ronau/hoerbert-clone/Assembly.md

Assembly
========

Here are some photos and notes from the assembly.

Board and wiring
----------------

1. Soldering the micro switches to the matrix board as well as the ground wires.
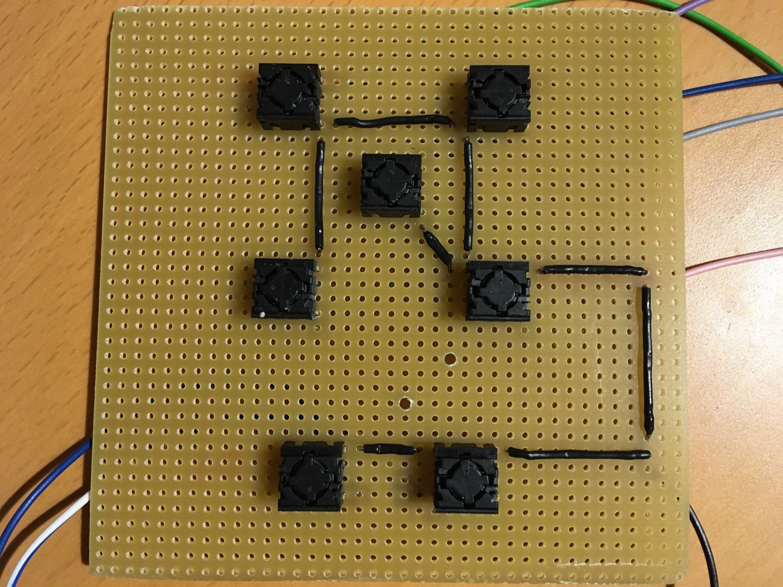
[picture p2: images/1_board_01.jpg]
1_board_01
  
2. Connecting the switches to the corresponding pins on the Lilypad (here: ground as well as fast-forward/backwards switches).
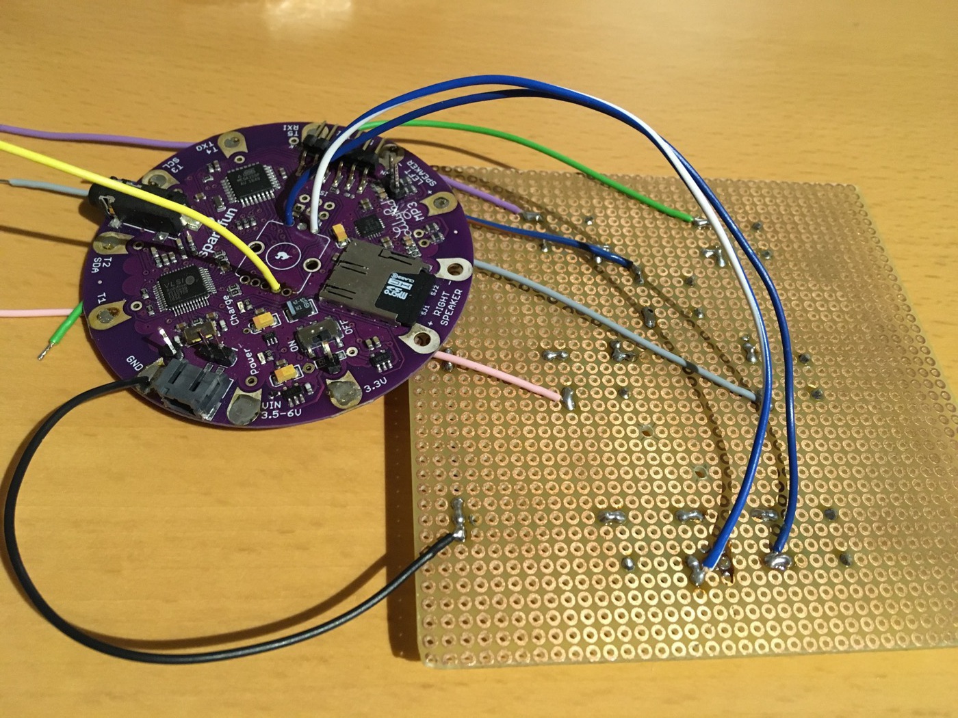
[picture p3: images/1_board_02.jpg]
1_board_02
  
3. Connecting the 5 playlist switches to the corresponding trigger pins on the Lilypad.
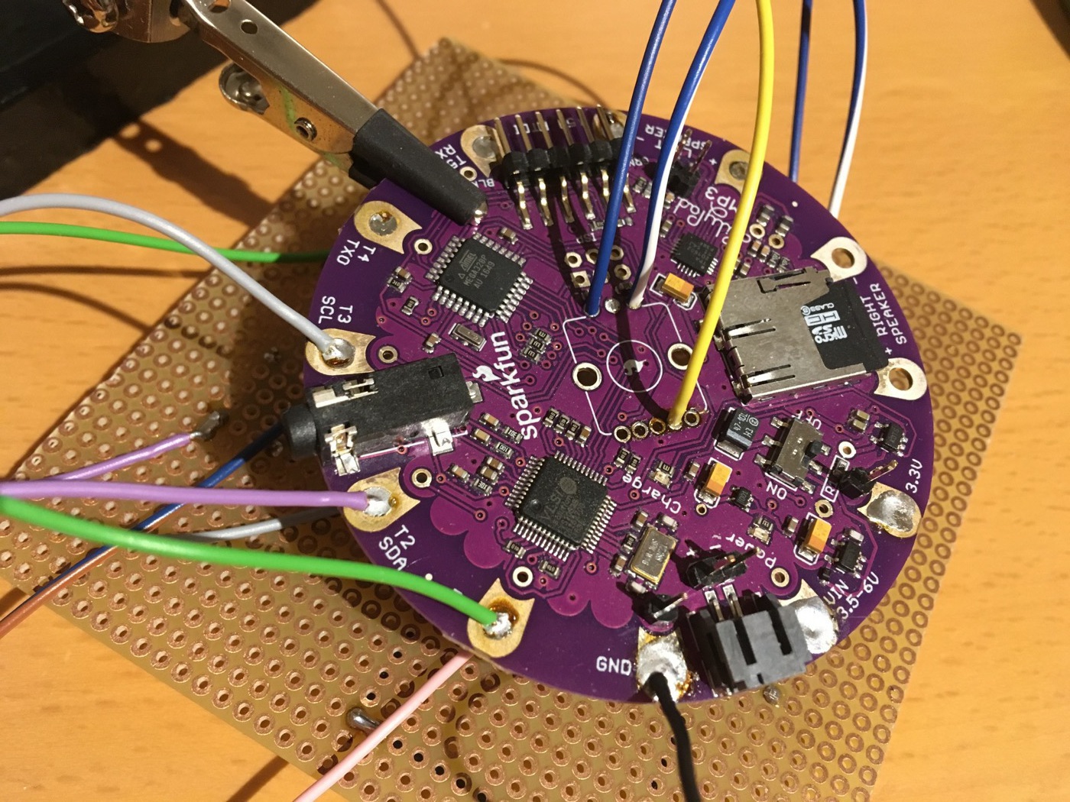
[picture p4: images/1_board_03.jpg]
1_board_02
  
4. Making sure the bottom of the Lilypad is protected when placing it above the matrix board.
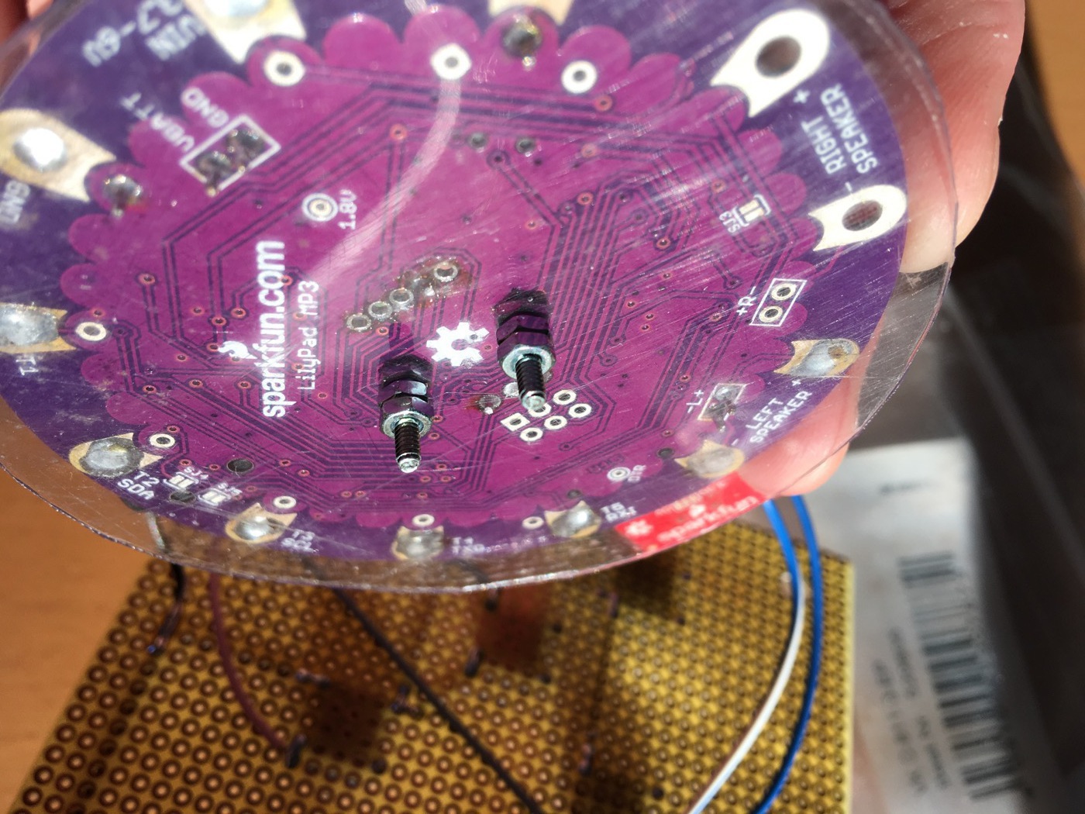
[picture p5: images/1_board_04.jpg]
1_board_04
   
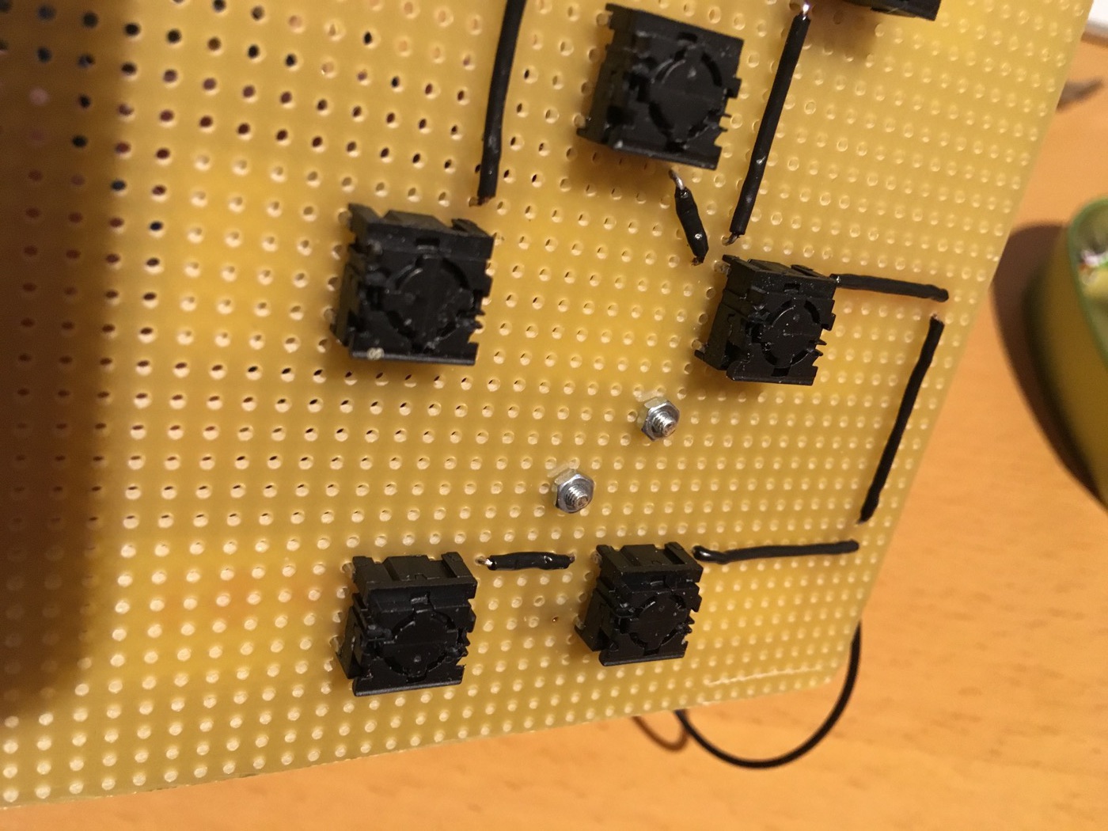
[picture p6: images/1_board_05.jpg]
1_board_05
   
5. Connecting potentiometer, battery and speaker and running some tests.
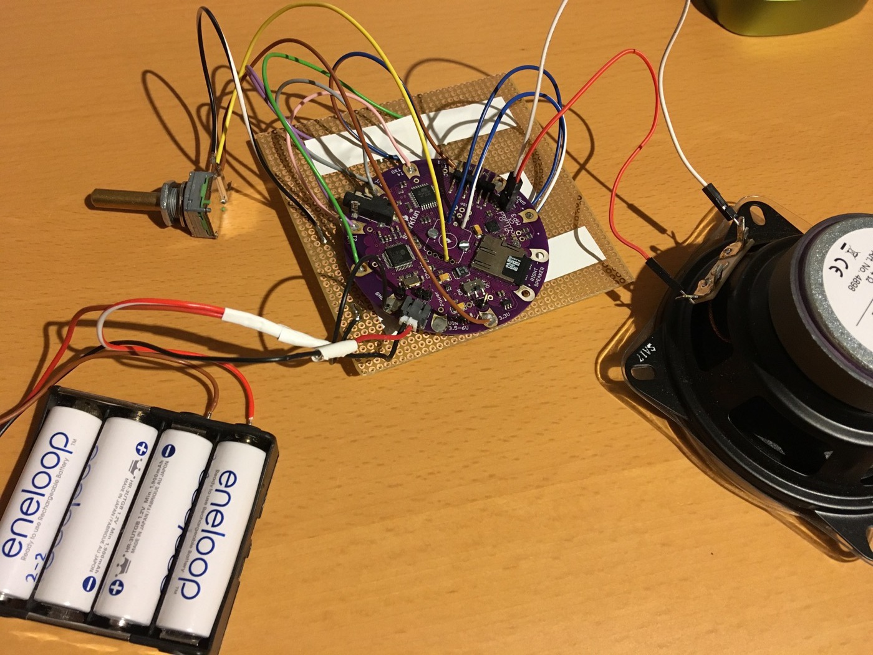
[picture p7: images/1_board_06.jpg]
1_board_06
   

Casing
------

1. Bezel for the speaker grid.
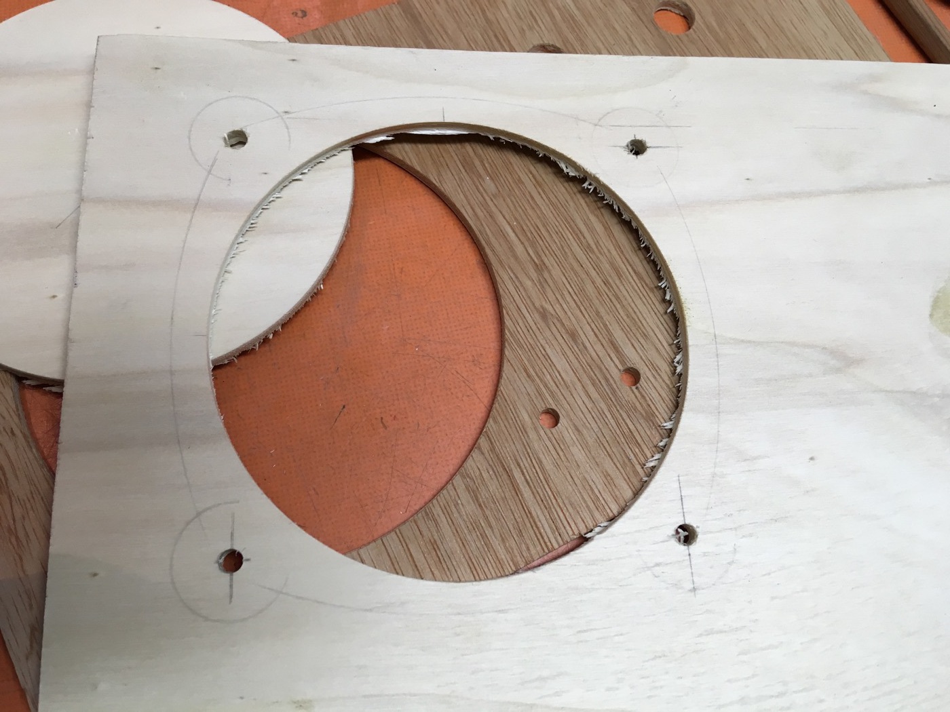
[picture p8: images/2_casing_01.jpg]
2_casing_01
   
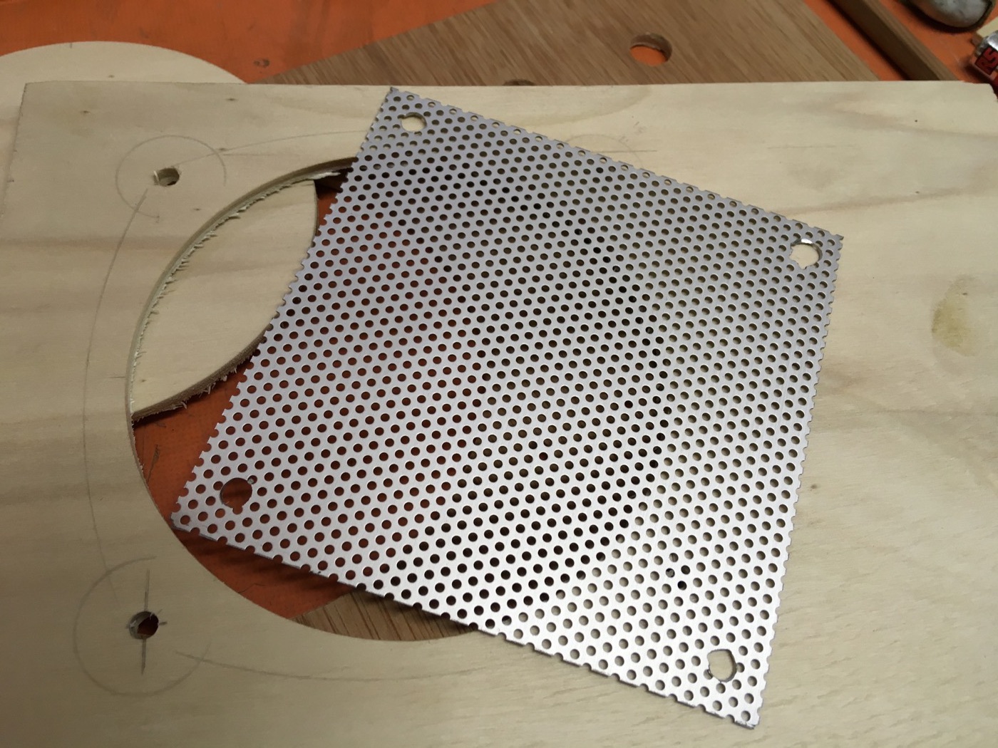
[picture p9: images/2_casing_02.jpg]
2_casing_02
   
2. Front plate with holes for buttons and speaker. It was a bit tricky to get the holes right so that the keycaps fit neatly without getting caught. File to the rescue.
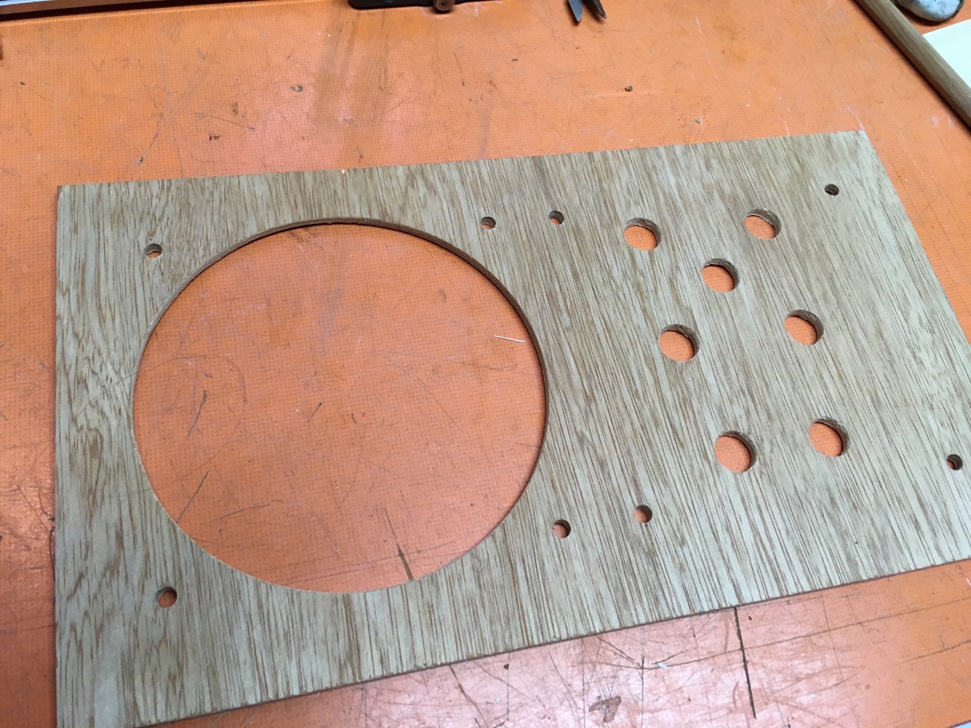
[picture p10: images/2_casing_03.jpg]
2_casing_03
   
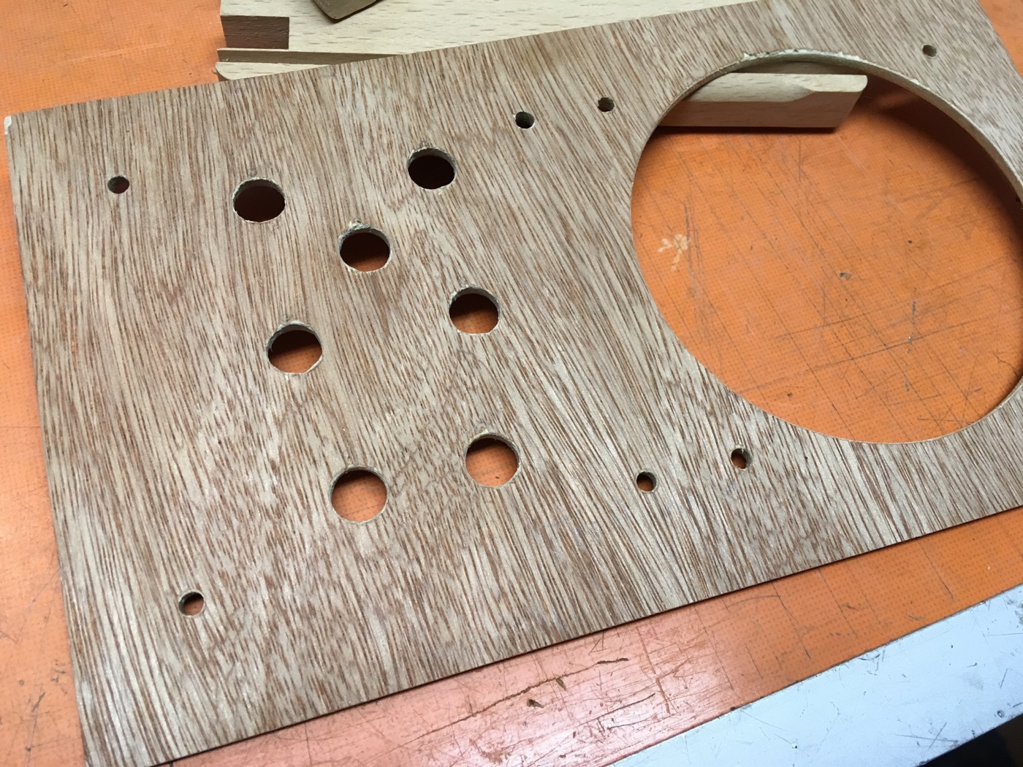
[picture p11: images/2_casing_04.jpg]
2_casing_04
   
3. Frame parts and handle. It's hardwood (beech), so it is recommended to pre-drill holes for battery holders and handle.
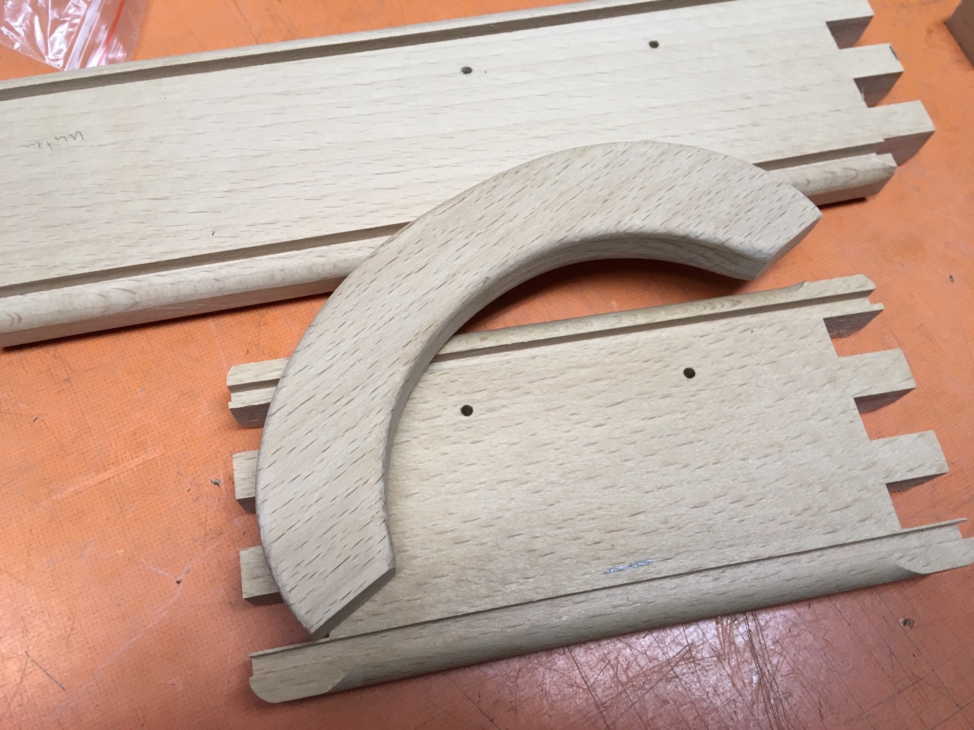
[picture p12: images/2_casing_05.jpg]
2_casing_05
   
4. Holes for power switch and potentiometer. On the inner side, the holes were broadened with a hole saw because switch and potentiometer need a lot of space.
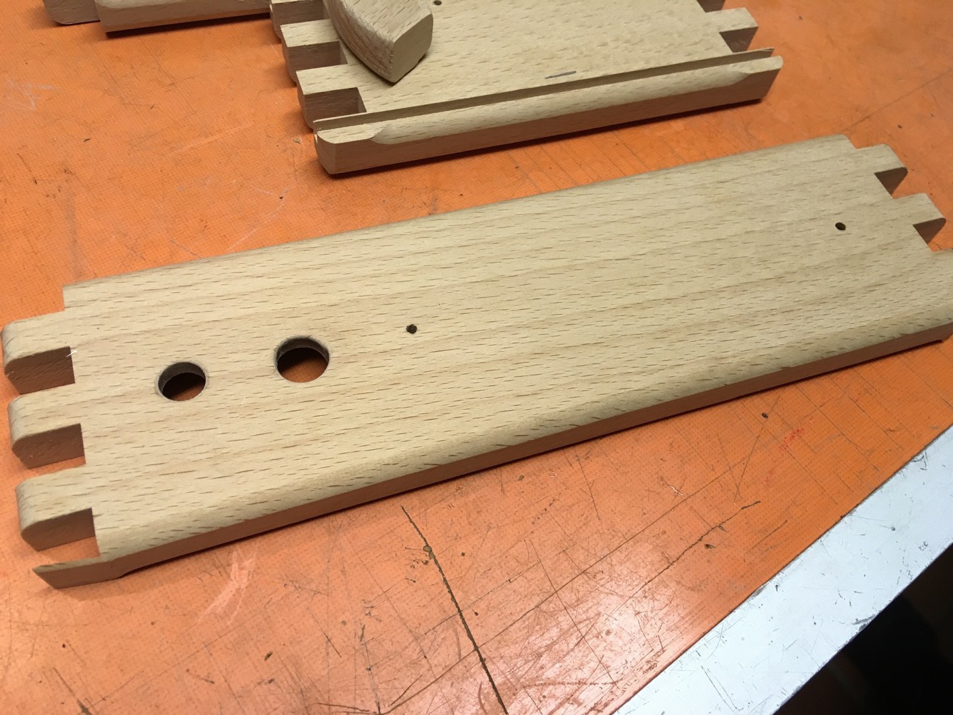
[picture p13: images/2_casing_06.jpg]
2_casing_07
   
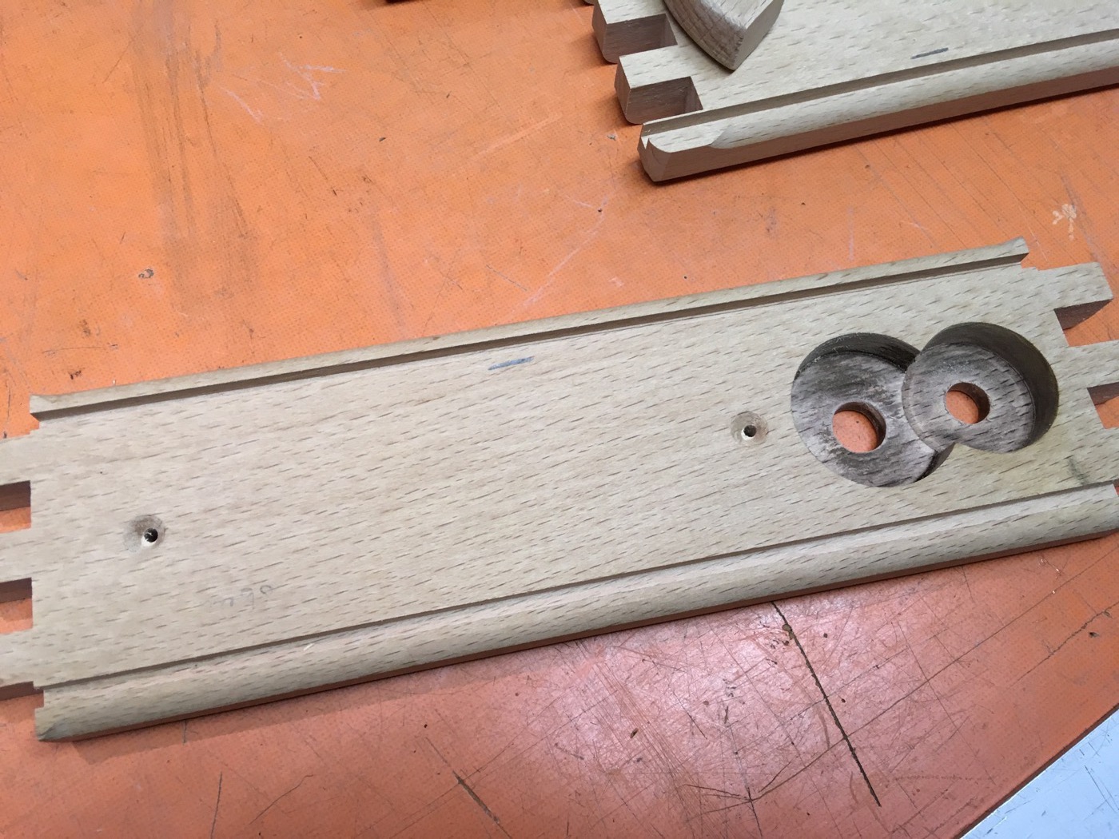
[picture p14: images/2_casing_07.jpg]
2_casing_07
   
5. Putting all parts together using wood glue.
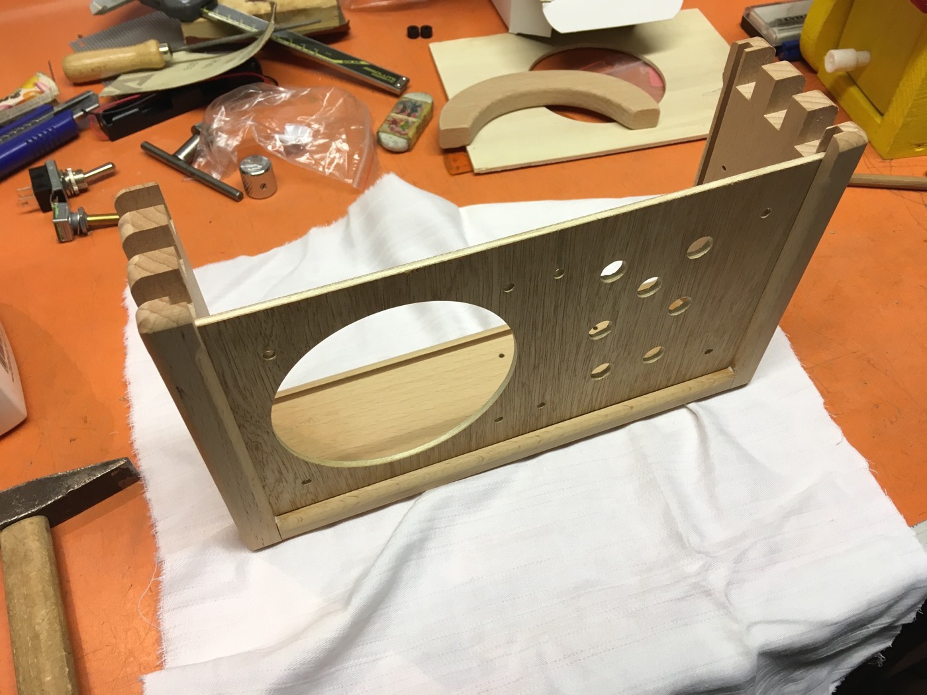
[picture p15: images/2_casing_08.jpg]
2_casing_08
   
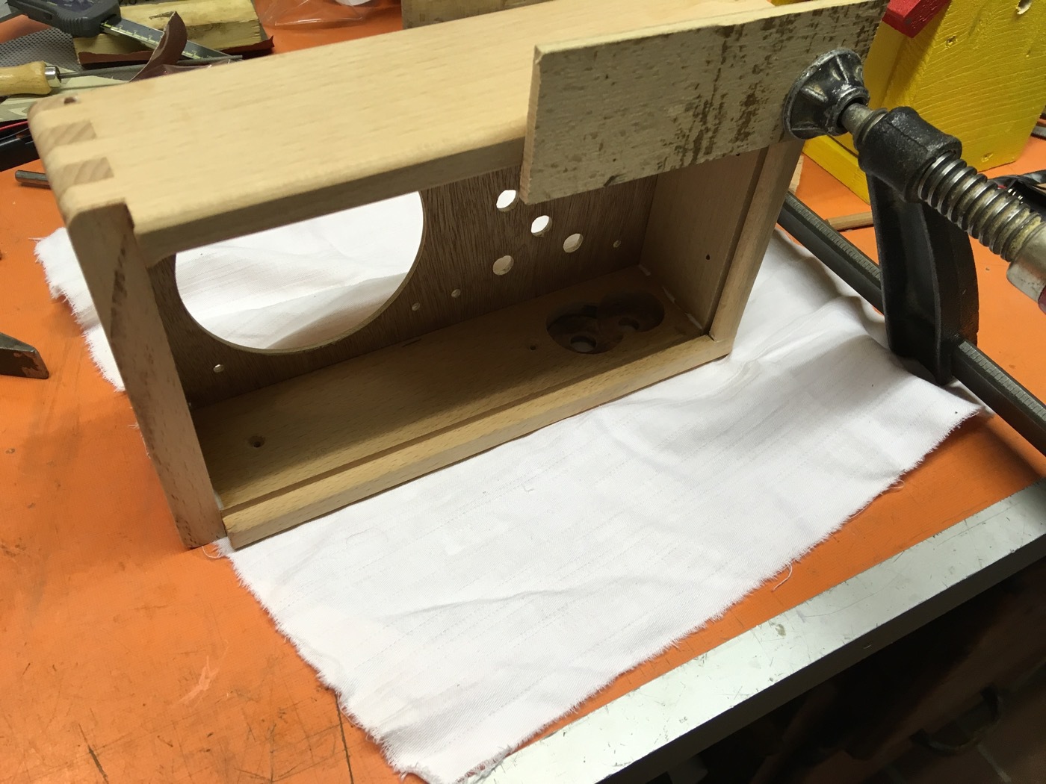
[picture p16: images/2_casing_09.jpg]
2_casing_09
   

Final assembly
--------------

1. Mounting power switch and battery holders. Power wiring. Using spacers to make sure the keycaps have the right height on the outer side.
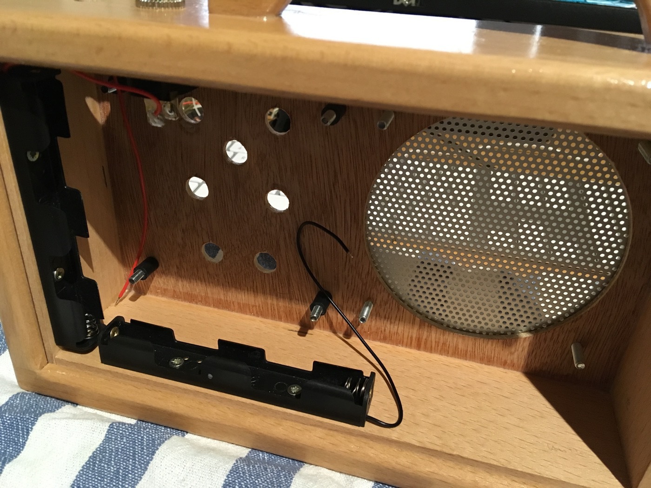
[picture p17: images/3_assembly_01.jpg]
3_assembly_01
   
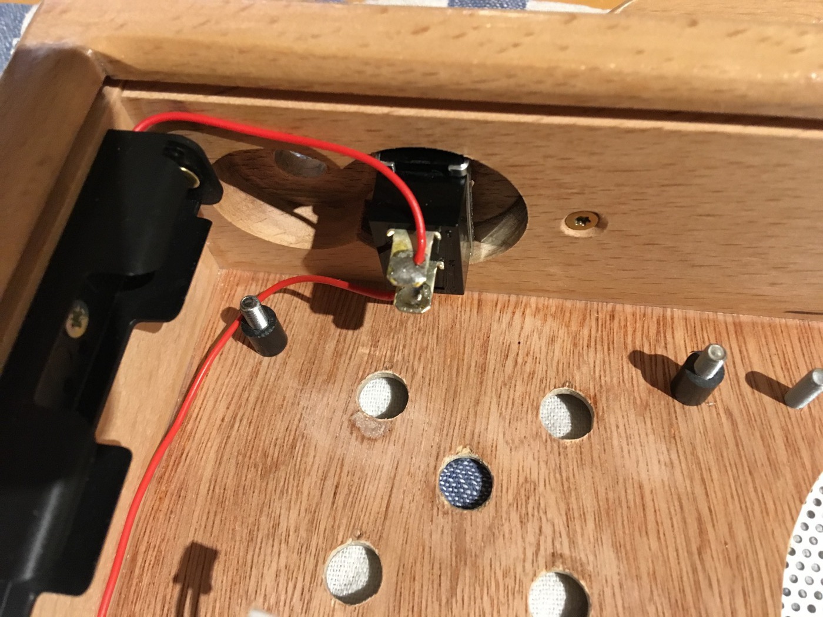
[picture p18: images/3_assembly_02.jpg]
3_assembly_02
   
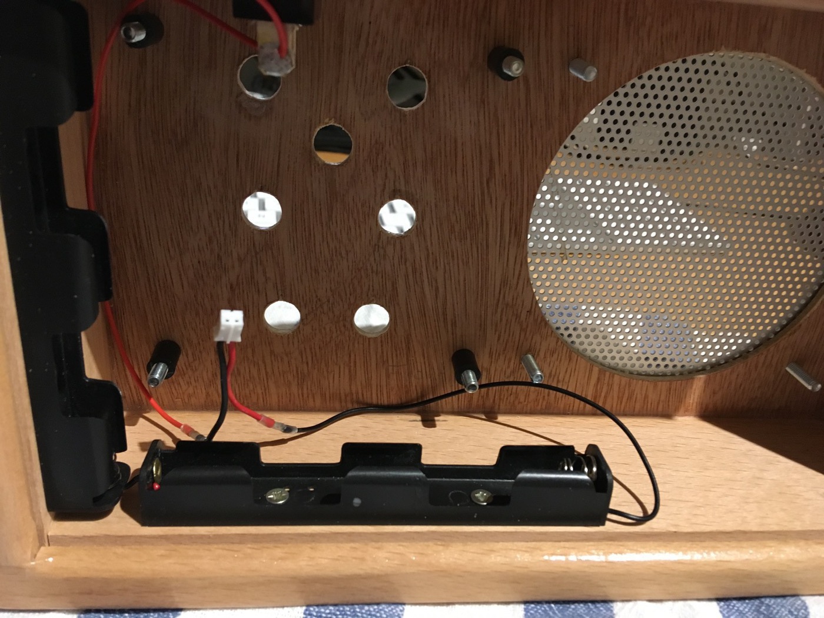
[picture p19: images/3_assembly_03.jpg]
3_assembly_03
   
2. Inserting and fasting potentiomer, board and speaker.
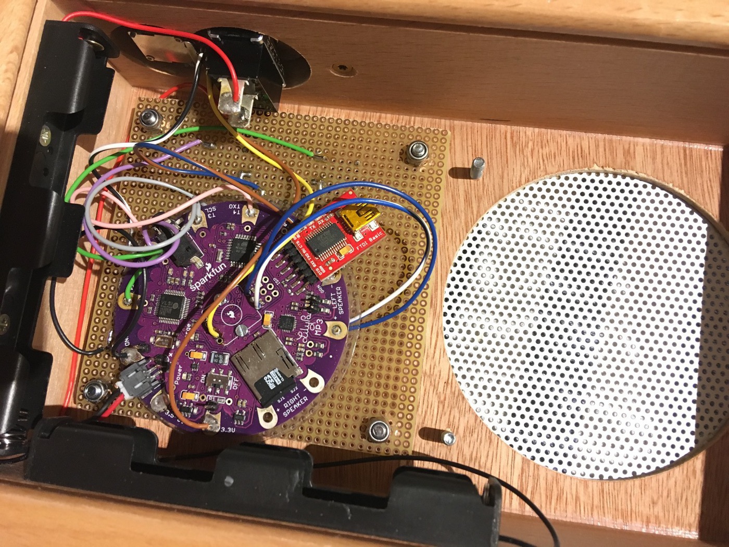
[picture p20: images/3_assembly_04.jpg]
3_assembly_04
   
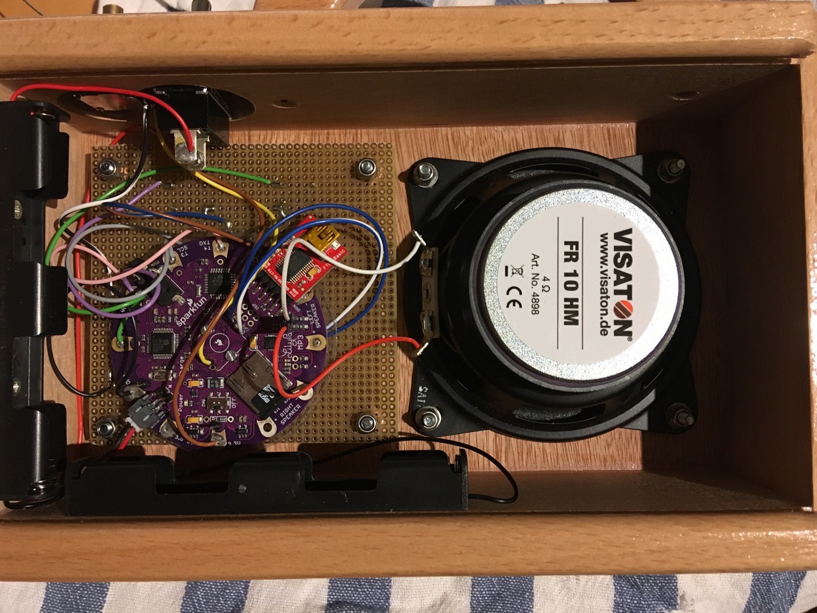
[picture p21: images/3_assembly_05.jpg]
3_assembly_05
   
3. Again, power switch and volume potentiometer from both sides. The shaft of the potentiometer needs to be shortened so that the knob fits correctly.
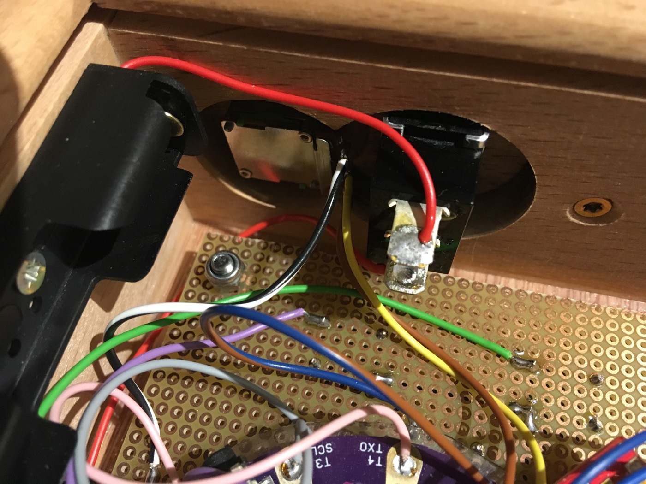
[picture p22: images/3_assembly_06.jpg]
3_assembly_06
   
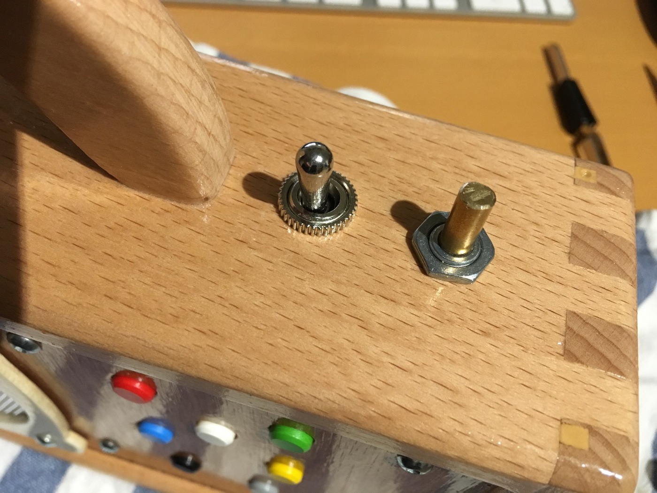
[picture p23: images/3_assembly_07.jpg]
3_assembly_07
   
4. Completed.
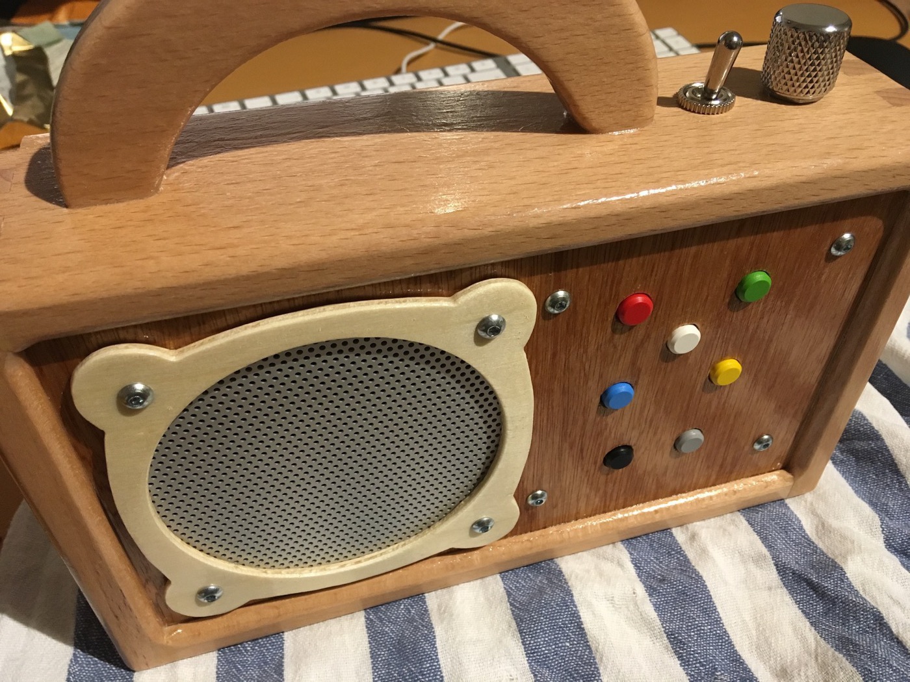
[picture p24: images/3_assembly_08.jpg]
3_assembly_08
