ronau/hoerbert-clone/(commit log)

2017-10-05 Plenty of refactoring (e.g. switching from define macros to const variables, etc. to save RAM)
2017-10-05 Added scanning and sorting of playable tracks in current directory.
2017-10-05 Functions for previous and next track adapted to consider sorted track list. Refactoring.
2017-12-15 Added IRQs for trigger buttons
2017-12-19 New UX! Jump to next track by pressing the button of the current playlist. Next button will now fast forward immediately. Prev button still jumps to previous track in current playlist.
2017-12-19 Commented out unused variables (button press timers). Debug output refactoring.
2017-12-20 Added resume function. On startup player will continue with last played track (from the beginning).
2017-12-23 Switched off automatic gain control of the amplifier chip, thus disabling confusing volume adaptations (e.g. on startup of player).
2017-12-23 Slightly increased minimum volume. Also, volume is now reduced during fast-forward (because of annoying sounds while skipping through the track).
2017-12-23 Fixed an issue with trigger button 5.
2019-02-22 Added license file, readme and assembly notes including photos
